Julak13/SmartVotingMachine/docs/block_diagram.jpg

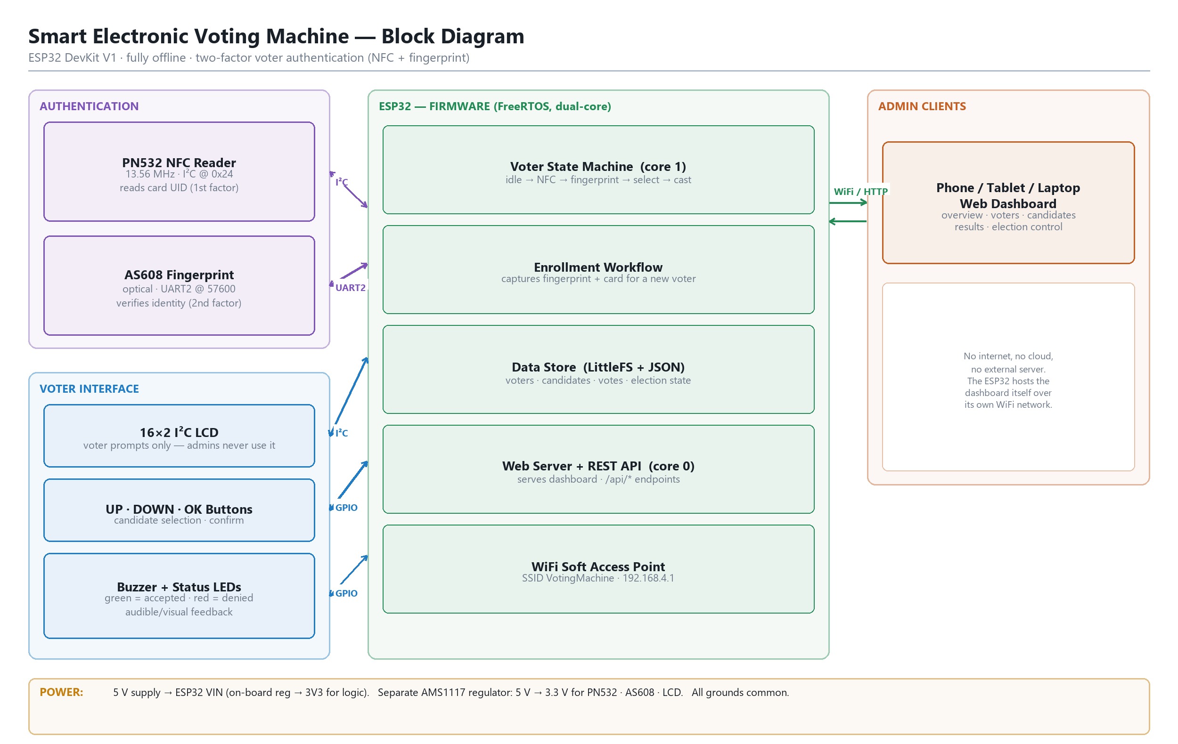
docs/block_diagram.jpg
