Julak13/SmartVotingMachine/docs/circuit_diagram.jpg

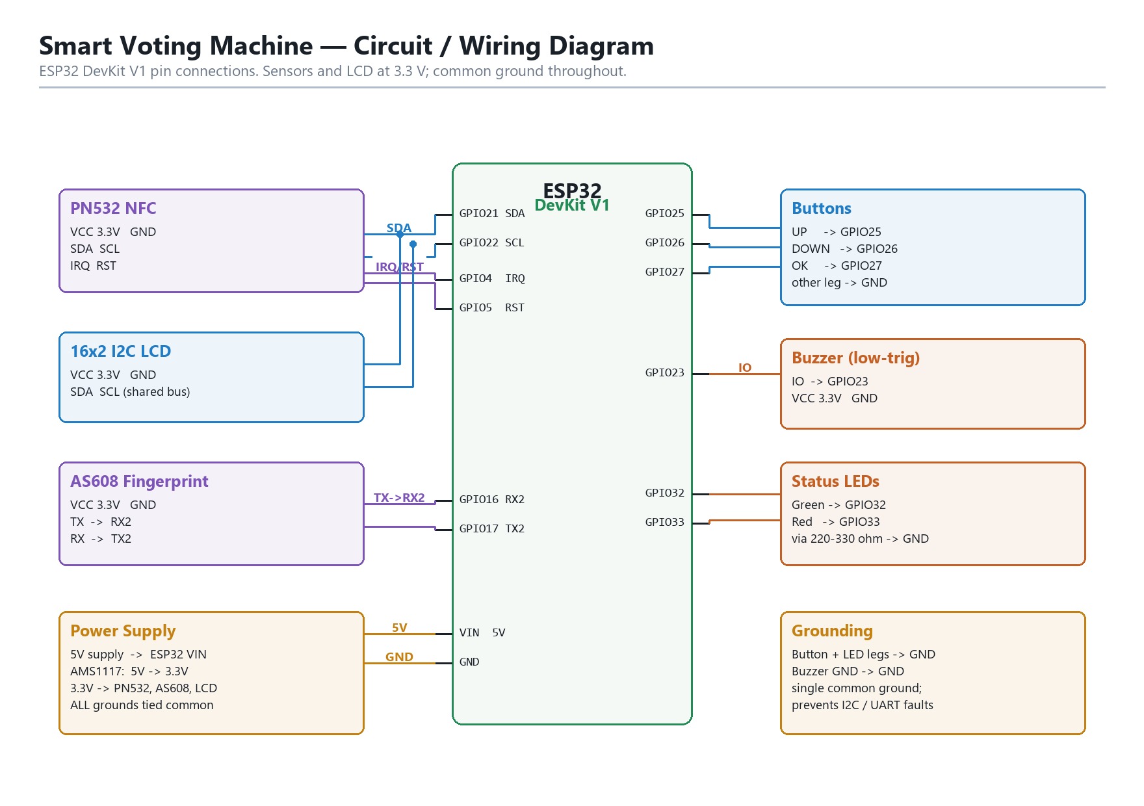
docs/circuit_diagram.jpg
