Julak13/SmartVotingMachine/docs/flowchart.jpg

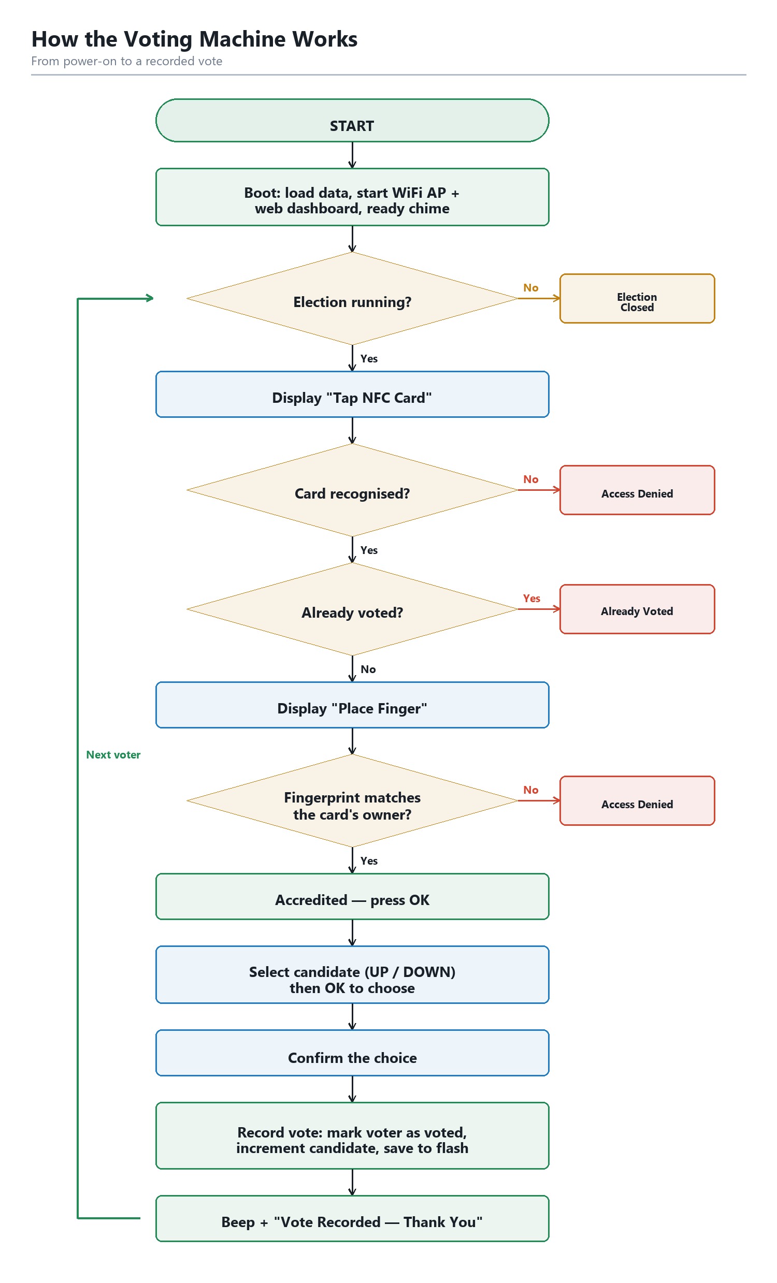
docs/flowchart.jpg
