Julak13/SmartVotingMachine/(commit log)

2026-06-19 Initial commit: ESP32 Smart Voting Machine
    Offline electronic voting machine for ESP32 DevKit V1 with two-factor
    voter authentication (PN532 NFC + AS608 fingerprint), voter-only LCD/button
    interface, buzzer/LED feedback, and a self-hosted WiFi admin dashboard.
    State persisted in LittleFS.
    [AdminServer.cpp, AdminServer.h, Buttons.h, Display.cpp, Display.h, Feedback.cpp, Feedback.h, FpSensor.cpp]
2026-10-15 v1.1.0: fix field issues, add Telegram results and browser updater
    Fixes reported by the client:
    - Candidate screen had no exit: a voter walking away froze the machine
    for everyone. Now cancels after 30 s without a button press.
    - NFC "tap several times": the PN532 searched forever while the host
    gave up after 250 ms, so the next command collided with the unfinished
    one. The chip now ends its own search inside the host wait; the reader
    also self-tests every 5 s and is hardware-reset (RST/GPIO5) if silent.
    - Smudged fingerprint reads were rejected outright; they are now
    re-imaged, with 3 clean non-matching reads before rejecting.
    - Same finger enrolled twice left one voter unable to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
    [AdminServer.cpp, AdminServer.h, Display.cpp, Display.h, FpSensor.cpp, FpSensor.h, NFCReader.cpp, NFCReader.h]
2026-10-21 v1.1.1: roll NFC back to v1.0 behaviour; add v1.0 fallback to updater
    After the v1.1.0 update the deployed PN532 reported "not responding".
    v1.1.0 was the only release to send the reader anything besides card
    polls: it bounded the card search with setPassiveActivationRetries()
    (whose reply the Adafruit library never reads) and ran a periodic
    getFirmwareVersion health check that hardware-reset the reader. Both
    are removed; the reader is configured once at boot and polled every
    250 ms exactly as v1.0 did. Only a reader missing at boot is retried.
    Root cause still unconfirmed on hardware - the docs now say not to
    reintroduce either change without testing on the real reader.
    All other v1.1.0 fi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
    [NFCReader.cpp, NFCReader.h, VotingController.cpp, config.h]
2026-10-23 v1.1.2: fix machine stuck on "Tap NFC Card" when voting
    Two causes, both fixed:
    1. Card reading timed out and re-sent the search. readPassiveTargetID()
    with a 250 ms timeout returns while the PN532 is still searching, so
    the next call landed on top of the running command and the two fell
    out of step - taps went unnoticed. v1.0 had the same method but its
    per-loop LCD redraw happened to leave ~70 ms between attempts; v1.1's
    LCD caching removed that gap and made it worse. NFCReader is now
    non-blocking, following the library's readMifareClassicIrq example:
    arm one startPassiveTargetIDDetection(), poll the 1-byte I2C status,
    readDetectedPassiveTargetID(), re-arm. Nothing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
    [NFCReader.cpp, NFCReader.h, VotingController.cpp, config.h]
